rfielding/octaveRounder/README.md

rob.fielding@gmail.com

bitcoin

#The Project

arduino

This is an arduino project for automated octave switching.  Run it as a proxy between midi out and midi in.

The end result is kind of like manual arpeggiation.  It lets you do extremely fast scale and arpeggio runs.  It isn't clock based, and doesn't make guesses.  It only plays notes you actually play, but octave switches to the nearest note to the previous note.  In practice it means that jumps up of a fifth or more shift octave down, and jumps down of a fifth or more shift an octave up.

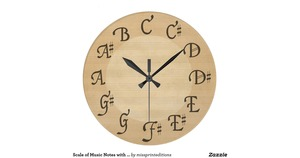
[picture p1: images/clock_small.jpg]
clock


There are twelve notes in an octave on a keyboard.  So an analogy with clocks is appropriate.
An octave contains notes modulo 12.  If it is 10 clock, and something is supposed to happen at 11,
then common sense dicates that this generally means 1hr into the future rather than 11hrs into the past.
Octave rounding uses this sort of logic, so that playing very quickly by omitting hand movements
through the octaves is the default.

#How To

The keyboard is a quartertone flat below middle C, and designed exclusively for playing mono voices.

Demonstration Video (Not a trained or proficient pianist at all):

(https://www.youtube.com/watch?v=IfWY_6Q8RX4)

https://www.youtube.com/watch?v=IfWY_6Q8RX4

And a tutorial video on using the quartertone split:

https://www.youtube.com/watch?v=vimtrlz7cGs

To build one, install the Arduino SDK:

http://www.arduino.cc

Buy an Arduino Uno, easily available from electronics stores for as low as $5:

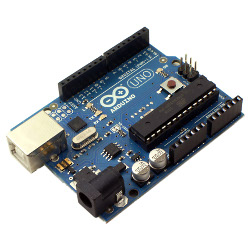
[picture p2: images/arduinouno.jpg]
Arduino Uno


>The Uno only has a 2048 bytes of RAM available.
>This current code uses about 512 bytes of RAM.

Buy a MIDI shield for roughly $20.  You typically need to buy them online.  I find them on Amazon (Olimex, LinkSprite).  You only need MIDI IN and OUT for these purposes (you can buy a partial MIDI shield that doesn't have a MIDI THRU, with only IN and OUT if you like):

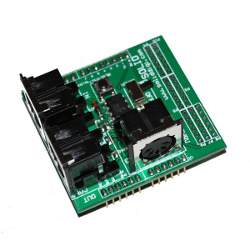
[picture p3: images/midishield.jpg]
LinkSprite MIDI Shield

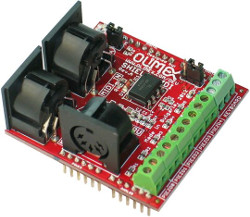
[picture p4: images/midishield2.jpg]
Olimex MIDI Shield


Stack them together.  Be very careful to align the pins correctly before plugging into USB (ie: the power source), or you can damage the board.  Then use the Arduino SDK to upload [octaveRounder.ino](octaveRounder.ino) into the Arduino board over the USB (press the 'Raw' button to get a downloadable link in your browser that you can right click to save-as).
  
>Note that in order to load programs, the MIDI shield usually 
>needs to be disabled with a switch/jumper during the program
>upload phase.  Your synth can also sometimes get into a strange 
>state while being programmed, and may need a reset if you leave
>cables plugged in during programming.  If you try to program
>with the switch on, you may need to press the reset button
>on the Arduino, set the switch for programming, 
>set the COM port again, and retry.

As always with MIDI, make sure that the keyboard is set to transmit MIDI out (usually on channel 1).  Then MIDI OUT from that keys controller into the MIDI IN of the MIDI Shield, and MIDI OUT from the Shield into the MIDI IN of the synth.  If your MIDI keys controller has a disable local keys option, use that.  If you can disable local keys, you can use the same device for keys controller and synth.  You will need 2 MIDI DIN cables, or at least will need the 5-pin DIN on the end that plugs into the Arduino.  Try to use different colors, as you will be unplugging and plugging them in very frequently.  A third cable for MIDI THRU will not be necessary for this pedal, because we don't use the clock signals in this program (ie: like arpeggiators do).
I use a Novation UltraNova for this purpose:

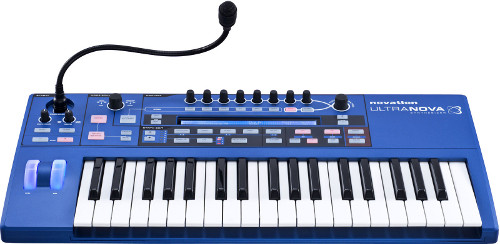
[picture p5: images/ultranova.jpg]
Novation UltraNova

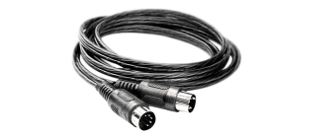
[picture p6: images/midicable.png]
cables

cables2

These are two of the prototypes.  One in a red plastic box has a dozen LEDs representing the current note down.  The other is the raw prototyping board for uploading code on a daily basis.  Some of these have used Arduino Mega 2560, but these just use Arduino Uno.

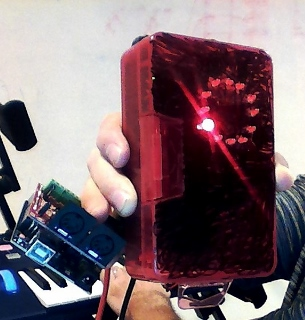
[picture p7: images/twoprototypes.jpg]
Prototypes


Once you have all of the parts you need, configure them and plug them together.  This diagram gives a complete inventory of what needs to be done.

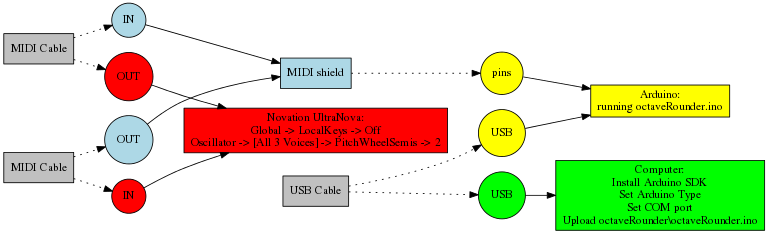
[picture p8: images/wiring1.png]
Inventory


>Note that you can make a minimal (and not optically isolated!)
>MIDI shield with two female MIDI DIN connectors and a pair
>of 220 Ohm resistors, but you may judge it to be too
>hazardous for the MIDI device that this is to be plugged into.

#What it does

At a basic level, it is doing automated octave shifting. Musically, it is manipulating a virtual octave switch.  It makes a tremendous difference when octave switching is automated, because the rhythm needs to be right when moving hands long distance or when hitting octave switches.  The arrowheads denoting an octave switch are done automatically, and occur when a change is more than 6 semitones (a tri-tone).

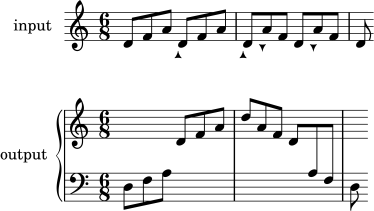
[picture p9: images/play_cropped.png]
play


The keyboard is virtually split at middle C.  Everything below middle C is a quartertone flat.  This means that when you hit a key on the low side, the pitch wheel goes down an extra half of a note (1/4 tone).  When you play a note on the other side, the adjustment is removed.  So, left hand plays the quartertone notes or normal notes; while right hand stays to the right of middle C.  The main point of quartertone scales is to have a pentatonic core scale, where all minor thirds can be split exactly in half with a 1/4 tone.

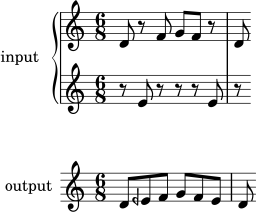
[picture p10: images/qtone_cropped.png]
qtone


As a matter of notation, the use of a quarterflat symbol (backwards flat) is simply the natural version of the note played on the left of the quartertone split of the controller.  A half-sharp symbol means to play the sharp on the quartertone split of the controller.  Ponder the unusual case where the core pentatonic scale is centered around black keys.  Then when we start from A flat, a minor third up gives us C flat.  The note in the center is a B flat that is played on the left side of the quartertone split.  This note is 3/4 tone flat from B.

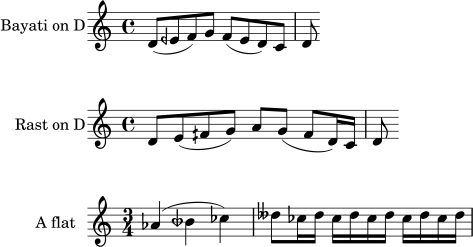
[picture p11: images/maqam_cropped.png]
maqam


And trilling works by holding down same note and playing notes in same octave, to double playing speed.

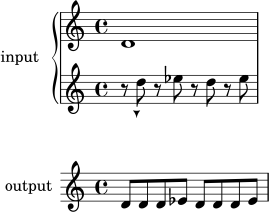
[picture p12: images/trill_cropped.png]
trill


When trilling across the quartertone split, playing the same note re-triggers the same note that is being held.  This lets you play scales that contain a mix of notes with quartertones, while still being able to trill.
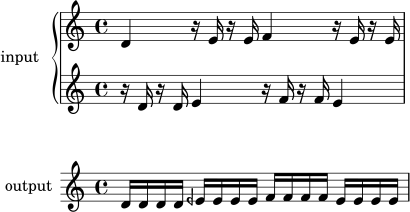
[picture p13: images/qtrill_cropped.png]
qtrill


When not traversing the quartertone split, the octave shift only moves by one note at a time.  As a consequence, you can still make octave jumps and higher.
This is because the octave split only moves by one octave at a time when both notes are on the same side of the split.

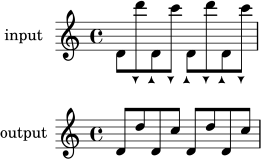
[picture p14: images/oct_cropped.png]
oct


Note that if you want to avoid the quartertone split, you can move it out of the way by hitting the physical octave "Up" switch on your keys controller.

>In future releases, the quartertone split might be moved down one octave so that quartertone split is off by default on short keyboards, but readily available by going down one octave with the physical octave switch button.

An appropriate rhythm and fingering can make fast runs very easy to do.  A common way of playing octave rounding is to pick 4 notes in the octave, and play the two lower ones with fingers of the left hand and two fingers of the right hand for the top two notes.

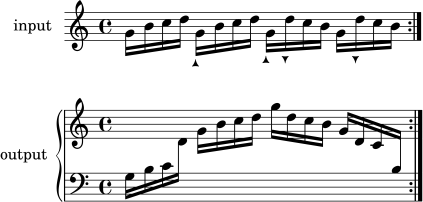
[picture p15: images/speed_cropped.png]
speed


#How It Works

The expected behavior of this MIDI filtering pedal can be clearly defined by saying what bytes we expect to come out of the pedal in response to certain bytes going in.  To simplify things, assume that we are going to work with MIDI channel 1 only.  We will talk entirely in terms of hexadecimal numbers when speaking of the protocol.  That means that MIDI:

- Turn on notes with a byte 0x90, a note number byte, then a volume byte
- Turn off notes with a byte 0x80, note number byte, and a parameter for how hard to turn it off.  This is a rarely used option.
- Turn off notes with a byte 0x90, a note number, but a zero volume byte.  This is what most MIDI devices do in practice.
- In our notation, green text with a '?' denotes byte input
- Text with a '!' denotes byte output
- In MIDI protocol, only the byte that begins a message can have its high bit set.  That includes 0x80,0x90,0xA0,0xB0,0xC0,0xD0,0xE0.  This means that for the second and third bytes of a message, the highest available number is 0x7F (ie: 127 in decimal).

A completely transparent pedal would simply emit exactly the bytes that were put into it.  But our filter will at the very least need to alter the note numbers to match up its internal notion of where its octave switch is at.  A simple downward arpeggiate rewrites the notes, and looks like this:

unittest1

Note that we see the note going up and going back down.  If our filter works correctly, all notes should eventually be back to zero no matter what we do to the keyboard.  This is an arpeggio going up (note the 0x0c is 12 in hexadecimal - the number of notes in an octave)

unittest2

Now we need to handle the pitch wheel.  Because we drop everything below middle C (note 0x3c) a quartertone, we need to filter the pitch wheel to add our own values to it.  So in this unit test, we simulate nudging the pitch wheel a little bit to make sure that everything is tracking correctly.  Before any note is played, the pitch wheel will need to be moved to be the correct pitch before the note is turned on.  The pitchwheel (ie: note bend) message is 0xE0.  The two bytes after that message are the pitch wheel value.  The first byte is the low 7 bits, and the second byte is the high 7 bits.  Note that a completely centered pitch wheel is: 0xE0 0x00 0x40, because that is half of the maximum value for the two byte arguments.  Note that this is why MIDI pitch bend has 14 bits of resolution.  We also assume that the pitch wheel is at the default of 2 semitones up or down.

unittest3
unittest3

The final behavior that we need to capture is in 'fixing' the standard behavior of MIDI mono synths.  MIDI mono synths track all of the notes that are down and stack them so that hammeron/hammeroff works correctly.  This allows for fast trill playing.  MIDI assumes that there will never be multiple copies of the same note (because it assumes that the controller is a keyboard with a unique key per note).  When using octave rounding, playing adjacent note D's will not be an octave apart, but be the exact same note.  So, when a note must be retriggered for the synth, we need to turn the note off before we turn it back on.  We then need to retrigger notes that have been buried when the key goes up (something that will happen for all other notes except when they are the same note).  This allows for an effect that is like guitar speed picking.  Note that it uses the most recent volume down so that the volume level can change over time, even though one key is being continuously held down.

unittest5 

#Implementation

In order to correctly set pitch bending on mono voice keyboards when a finger comes up, we need to model the algorithm that the synth uses for note stacking in mono voices.  It appears that if the algorithm is to pick the newest note on as the leader when a note is off, then it matches most (if not all) synths.  So that is the algorithm that is used.  So we fully track state that we forwarded on to the synth.  We know the note re-mapping, volume re-mapping, and an id that lets us track the order in which these notes were sent.  This table, with rcvd\_note being the row, uses almost all of the RAM that is used in the program:

|rcvd\_note |id |sent\_note  |sent\_vol|
|---:|-----:|---:|---:|
| 0| | | |
| 1| | | |
| ...| ...| ...| ...|
| 60| 35| 48| 33|
| 61| 32| 49| 83|
| 62| 34| 50| 52|
| ...| ...| ...| ...|
| 126| | | |
| 127| | | |

>In this table, all blank entries are zero.  When all fingers come up, id starts from 1 again.
>
> Note that the current implementation does not literally use an array.
> Since there will never be more than a dozen fingers down at once,
> A sparse array is used, and set/get functions supplied to access the array.
> When a note slot has been freed by note up, we call a free on that element
> to free the array slot.  This way, rather than having (3 x byte x 128) usage,
> we have (4 x byte x 12) usage instead.
> This is critical in staying below 512 bytes of total storage, which
> the smallest devices must fit into, such as Arduino Mini.

Because incoming notes get translated into outgoing notes, we record the sent note to make sure that we turn off the note that we turned on in the synth.
When a note is turned off, the sent\_vol is set to zero along with the id.  We have three notes still on.  There are gaps in the notes still turned on, because fingers have come up since this chord was held down.  If finger 62 comes up, there would be no audible response, as that note is still buried by finger 60.  Since finger 60 has the highest number, it is still the leader.  If finger 60 instead came up, then 62 would be the new leader, as it would have the highest current id.

If we want to figure out how many outstanding versions of note 50 have been sent, we scan the entire table and just count the occurrences of sent\_note is 50 where sent\_vol is not zero.  If we go to turn on a note, and find that it is already on, then we send the MIDI notes to turn it off before we turn it back on.  By doing this, anybody that is counting the increments and decrements for a rcvd\_note will come out to zero once all fingers are up.  If we ever went below zero, then we should panic and reset the pedal to its initial state, because that means more note downs than ups.  This can happen if MIDI notes are lost by plugging and unplugging cables while notes are held.

The mapping from rcvd\_note to sent\_note is done by the note\_adjust variable.  This is the heart of octave rounding.  When a note is turned on by way of rcvd\_note, we remember where on the keyboard that was.  We compare the previous rcvd\_note value to the current one.  If the difference is greater than 6 (in units of semitones), then we shift the octave down by subtracting 12 from the note\_adjust variable.  Likewise, if the difference is less than -6, then we shift an octave up by adding 12 to it.  If both of these notes are on the same side of the quartertone split, then we only shift by one octave.  That allows the possibility of having note jumps that are larger than a fifth.  If we are on opposite sides of the quartertone split, then we shift octaves until the diff is between -6 and 6.  Note that for staying in range, we will add in octave shifts as well.  We do this so that we don't send garbage data to the synth with MIDI note numbers that are either negative or above 127.

Note that in the implementation that we only read new bytes in the main loop, where we simply consume all available bytes.  Because we may shift or rewrite the information we send, we rely on MIDI protocol using fixed length messages.  We enqueue full messages before sending the response.  We do this so that we can do things like insert pitch bends before note sends, or insert note off before redundant note on, etc.

#MIDI IN Powered

It is possible (desirable actually), to just use Arduino Pro Mini 5v
boards to just allow MIDI IN itself to supply the power.
This allows you to also reduce costs to that of a $5 board,
an $8 MIDI cable (that you cut in half), and a one time-cost of an FTDI
programmer ($10) to program these boards.

This works by borrowing MIDI pin 4 for power, pin 2 for ground
at our intercept point in the cable.
We then take pin 5 (which was our MIDI IN's tx from its point of view),
and send it into the Arduino at rx, and send it back out as tx.

Because MIDI does not seem to define unpowered circuits,
this circuit is non-standard.
I pass both rx and tx through 220 Ohms for the safety of the components
that connect to us.
We cannot be optically isolated like the standard MIDI circuit,
because we get our power from the input.

>Note that in the MIDI standard circuit (documented in the MMA website),
>they have a strange feature where MIDI out connects to the ground
>wire (2) of the cable, but the MIDI in does not connect it.
>That means that it's possible that you may have a MIDI cable that
>only connects pins 4 and 5 internally, and it could work with normal powered
>devices.  In fact, many MIDI cables save on cost by not bothering to have
>wires 1 or 3 in the cable at all (not used in the spec, sometimes used
>for phantom power).  An even cheaper cable might remove wire 2 even though
>it is explicitly mentioned in the standard.
>
>The ground on wire 2 being connected on only one end of the 
>cable seems to exist for exactly this purpose.

This is what the circuit looks like

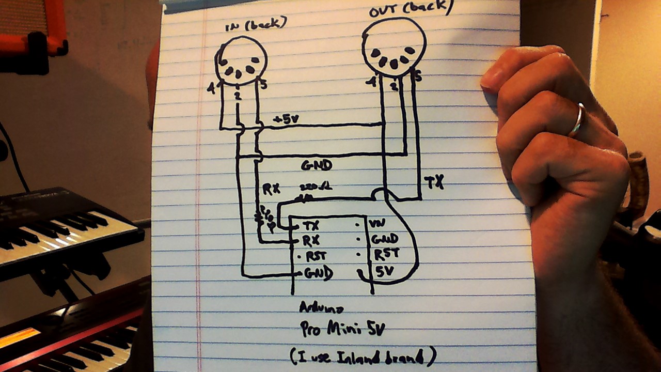
[picture p16: images/minipro5vcircuit.jpg]
circuit


Here is a working implementation of it.
Notice that there is no power going into it, yet it works.
It is using standard 3-pin MIDI to do this, so it is not using any extra pins.
Only a few devices that I know of (Ploytec PL2) use this technique.
This is only possible because of the extremely low power consumption of
these boards. 

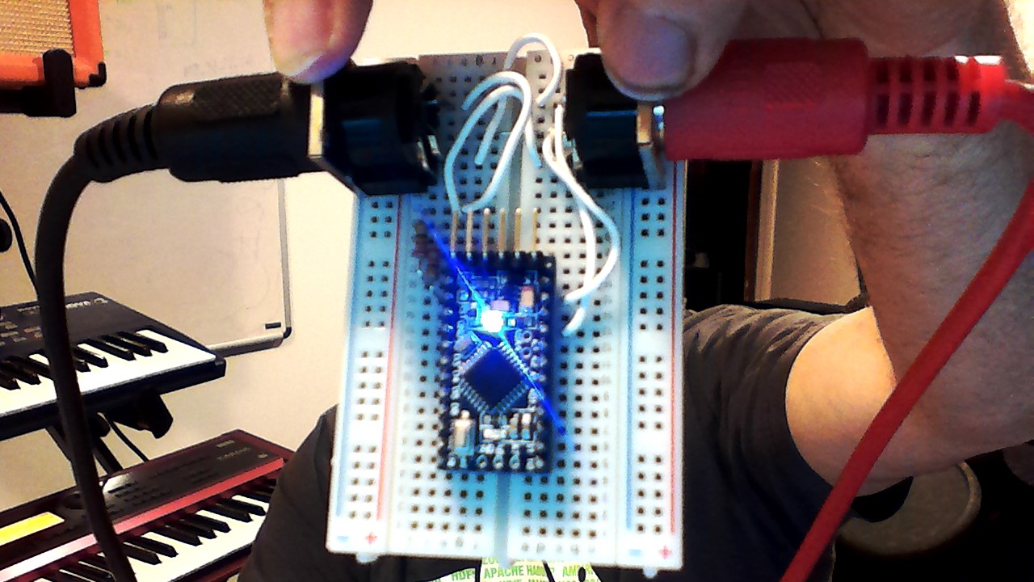
[picture p17: images/minipro5vscreen.jpg]
screen


And here is one that you can fit into your pocket because it's just
a short MIDI cable cut in half with the board inserted into the middle.
This is useful for keeping with you for trips to guitar center, to discretly
try this out on synths.

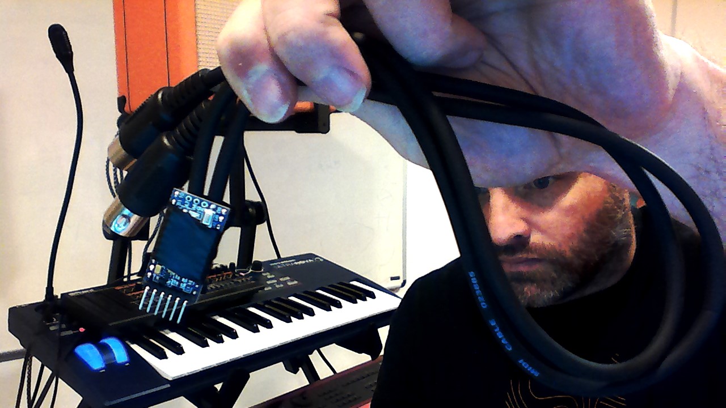
[picture p18: images/cutupcable.jpg]


The cut up cable may be electrically unsound without the resistors on tx/rx,
so this is one that puts those signals through 220 resistors.  It works
exactly like the cut up cable does, but I have more confidence when plugging
this into equipment that I do not own.

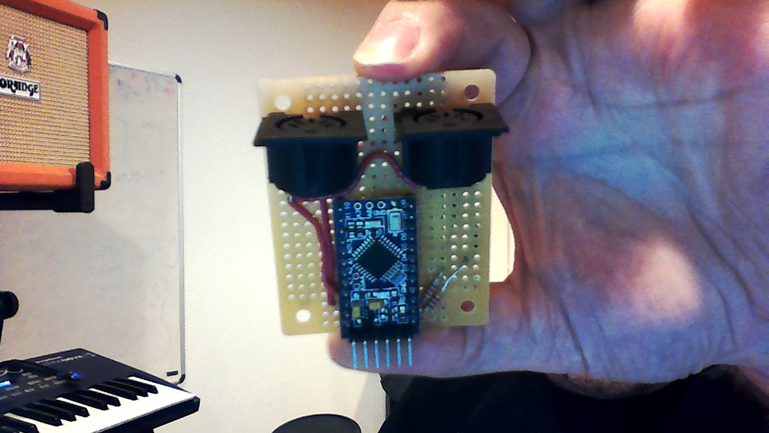
[picture p19: images/unpowered_permanent_220.jpg]


#Todo

There exists code for a display and some external buttons, with manual octave up/down in particular.

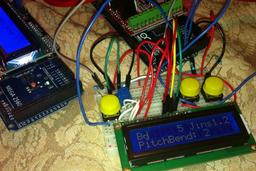
[picture p20: images/display_small.jpg]
display


The problem with it is that including it creates a dependency on building a more complicated physical board and upgrading to a Mega board.  Ideally, all master branch code going into this pedal can be made in a solder-free way by stacking an Arduino with a shield.  There are display shields available that also include the buttons (and have different pin assignments to the Arduino as well).  But the problem is that the MIDI shields and the display shields both assume that they are the only shield that is being stacked.  Re-soldering the pin headers on the Arduino with stackable headers such that the MIDI shield can be stacked *under* the Arduino (rather than on top, where the display is) is probably the easiest workaround; though it's still not ideal because the MIDI shields are generally pretty tall.  The other solution is to make a PCB that sandwiches in between the display and the Arduino to extend the board out to another set of pins that looks like an Arduino to the MIDI shield.  In general, trying to keep shields and Arduinos modular seems to call for such boards sandwiched in between 1 shield and an Arduino, where these boards would be the appropriate place to do any soldering or general breadboarding.
