rfielding/octaveRounder/(threads)

Thread 1 (2015-09-03):

pitch wheel

rfielding, 2015-09-03:
quartertones only work when the pitch wheel setting matches the synth setting.  if program (ie: voice) changes always sent state such as how many semitones are used for the pitch wheel, we could easily adapt.  we could also take another approach and just set the pitch bend width if we don't know what it is already.  but for that option, the tricky part is when this is done.  should it done on demand by a button? when the arduino is reset? in response to a program change?  if the program changes, then what is the deadline for sending this?  send it in response to a quartertone note being played?
