rfielding/octaveRounder/(commit log)

2015-06-27 auto format and refactor note on/off filtering
2015-07-01 led box version
2015-07-04 cleanup code. can't avoid stuck note if i include retriggers. commented out.
    [octaveRounder.ino]
2015-07-04 fixed bug in retriggers
    [octaveRounder.ino]
2015-07-04 seems to be a problem when wrapping around. HACK
    [octaveRounder.ino]
2015-07-04 handle case where octave switch doesn't roll over, but playing notes on a non-switched note does
    [octaveRounder.ino]
2015-07-11 Footswitch pin 10, octave round active pin 12
2015-08-30 fixed wraparound bugs, trill bugs, wrong octave bugs
    [octaveRounder.ino]
2015-08-30 update readme to reflect current pedal
2015-09-01 fix what may be the cause of rare stuck at bottom bug
    [octaveRounder.ino]
2015-09-03 add in support for pitch bend change
2015-09-03 removed the actual changing of pitch bend for now, as it's not right on ultranova
2015-09-05 respond to a reset
    [octaveRounder.ino]
2015-09-05 document issue with trill
    [octaveRounder.ino]
2015-09-05 put in a comment about the fishy behavior that seems correct anyway
    [octaveRounder.ino]
2015-09-05 pitch wheel looks right, but doesn't seem to be getting messages. maybe it is my synth
    [octaveRounder.ino]
2015-09-05 use the Arduino code formatter
2015-09-05 include digital write pin code for the red prototype box
2015-09-05 put in picture of some of the prototypes
2015-09-06 add in note about octave switching still allowing for octave wide and higher jumps
2015-09-06 note that octave switch is automatic beyond tri-tone
2015-09-06 add in midi cable note
2015-09-06 add second midi cable, and comments about programming switches
2015-09-07 add arduino image
2015-09-11 add in comment about adding displays and buttons to the base project
2015-11-01 add in info about MIDI in power and Pro Mini boards
2015-11-05 cut memory usage in half for SRAM - to 256 bytes
2015-11-08 cutup cable scenario
2015-11-12 don't allow wraparound because tickspace is a power of 2
